ProVirusPro/BarBot/schema_collegamento.jpg

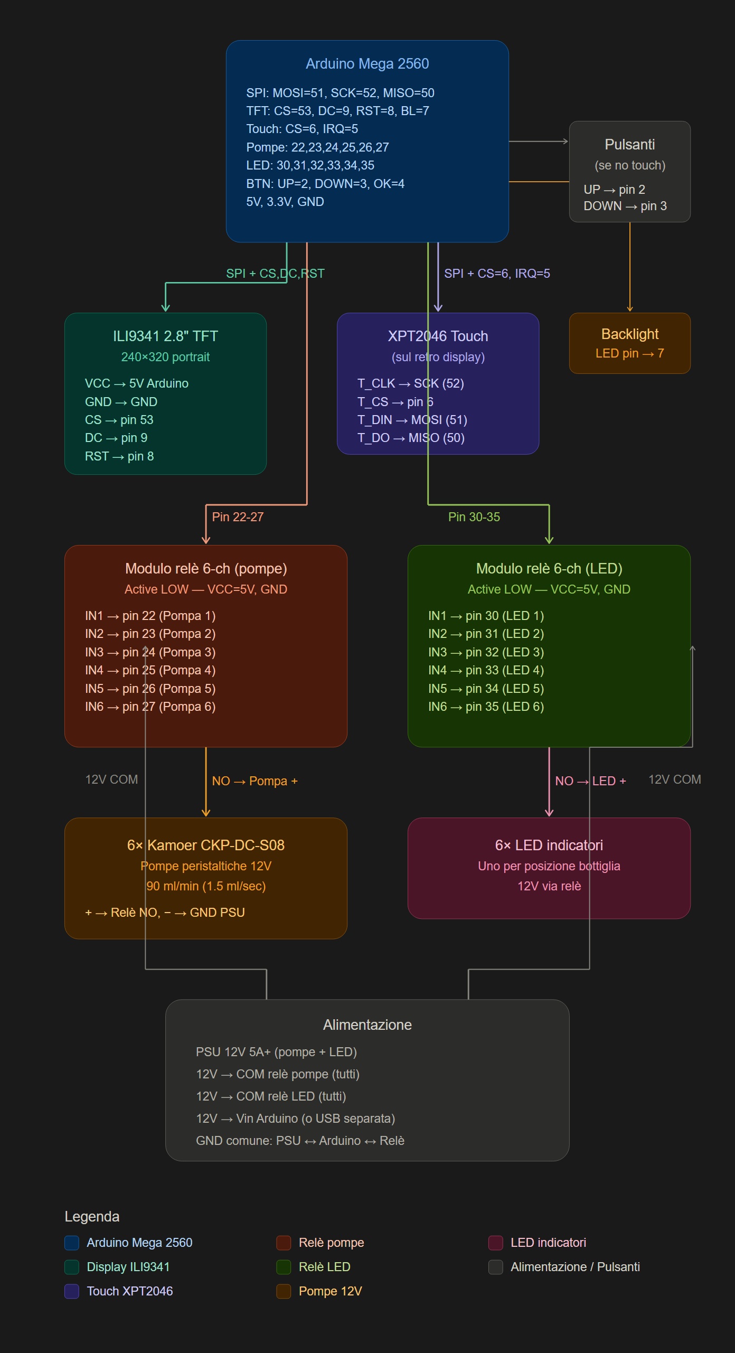
schema_collegamento.jpg
