ProVirusPro/BarBot/(commit log)

2026-09-16 Initial commit: BarBot cocktail mixer firmware
    Arduino Mega 2560 + ILI9341 TFT + 6x Kamoer peristaltic pumps.
    Parallel dispensing, touch/button UI, EEPROM persistence, 18 cocktails.
2026-09-23 Add display ID check on serial output at startup
    Reads ILI9341 chip ID via SPI and prints result to Serial Monitor
    for verifying display connection.
2026-09-23 Slow down SPI clock to 1 MHz for HW-221 level shifter
    TXS0108E on HW-221 can't handle the default 40 MHz SPI clock.
    1 MHz is reliable through the level shifter, display refresh
    speed is not critical for menu UI.
2026-09-24 Debug touch: remove IRQ dependency, add boot test
    - Use polling mode (no IRQ pin) for XPT2046
    - Add 3-second touch test at startup with serial output
    - Helps diagnose if touch works through HW-221 level shifter
2026-09-24 Clean up: remove all debug output, final release version
    - Remove display ID check at startup
    - Remove touch serial debug logging
    - Remove touch boot test
    - Keep SPI at 8 MHz for HW-221 level shifter
    - Keep touch in polling mode (no IRQ)
2026-09-24 Fix touch calibration: invert X and Y axis mapping
    Both touch axes were inverted relative to screen coordinates.
    Swapped TX_MIN/TX_MAX and TY_MIN/TY_MAX in map() calls.
    Removed debug serial prints from getTouch().
    [barbot.ino]
2026-09-25 Add Acqua, allow duplicate bottles, add Init Pompe and Svuota Tubi
    - Added "Acqua" to bottle list (index 0), shifted all cocktail recipe
    indices accordingly, bumped EEPROM magic to force reset
    - Removed restriction preventing same bottle on multiple pump slots
    - Added tube priming function (Init Pompe): runs pumps with assigned
    bottles to fill 90cm of tubing (50cm bottle→pump + 40cm pump→output)
    - Added tube flushing function (Svuota Tubi): runs all 6 pumps to
    empty tubes completely
    - Both functions accessible from renamed "Setup Pompe" menu
    - Tube volume calculated from configurable inner diameter (4mm default)
    [barbot.ino]
2026-09-25 Fix tube diameter to 2.5mm, prime only bottle-to-pump section
    - TUBE_ID_MM changed from 4 to 2.5mm to match actual tubing
    - Init Pompe now fills only the 50cm bottle→pump section
    - Svuota Tubi still flushes the full 90cm (bottle→pump→output)
    [barbot.ino]
2026-09-27 Truncate long drink names in detail header to prevent back button overlap
    "Espresso Martini" (16 chars) overflowed into the back button area.
    Now capped at 15 chars in the header; full name still shown in menu.
    [barbot.ino]
2026-09-27 Add Setup submenu with Pompe/Luci, animated beer icon, bigger UI slots
    - Rename "Setup Pompe" to "Setup" with submenu: Pompe and Luci
    - Add Luci screen: toggle individual LEDs on/off, Tutte ON/OFF
    - Make BARBOT title bigger (textSize 4) with animated beer mug icon
    - Beer icon sways left/right using sin() oscillation
    - Setup Bottiglie slots use textSize 2 (drawBtn) for readability
    - Update navigation: Main→Setup Menu→Pompe/Luci, back buttons
    [barbot.ino]
2026-09-27 Modern progress bar with glossy effect, rotating drink quotes
    - Taller progress bar (36px) with dark inset track and teal border
    - Glossy highlight band on the fill for 3D depth effect
    - Larger percentage display (textSize 3) below the bar
    - 12 fun/philosophical drink quotes in PROGMEM (Italian)
    - Quotes rotate every 4 seconds during dispensing
    - "Cin cin!" message on completion
    - Centered quote text with quotation marks
2026-09-27 Colored icons, textSize 3 quotes, fireworks on completion
    - Per-icon colors: cyan martini, yellow star, red heart, magenta note, blue drop, light cyan diamond
    - Quotes upgraded to textSize 3 with teal color, word-wrap at 13 chars
    - Shortened quote strings to fit textSize 3 (max ~22 chars)
    - Added animated fireworks on completion screen (3.5s, 6 colors, 8 rays per burst)
    - Centered "PRONTO!" + "Cin cin!" (textSize 2) above fireworks
    [barbot.ino]
2026-09-27 Distinct header colors per screen, fix quote text overflow
    - Each menu screen now has a unique header color:
    Setup Bottiglie (teal), Seleziona (green), Drink Menu (magenta),
    Preparazione (orange), Pompe/Calibra (purple), Setup (blue), Luci (gold)
    - hdr() now accepts optional color parameter (defaults to C_HDR)
    - Fixed quote word-wrap overflow: "Dosi giuste, magia!" second line was
    15 chars (270px > 240px screen). Changed split search from pos 12 to 13.
    [barbot.ino]
